pierre-muth/flipdot-ring/Screenshot 2026-03-23 202753.jpg

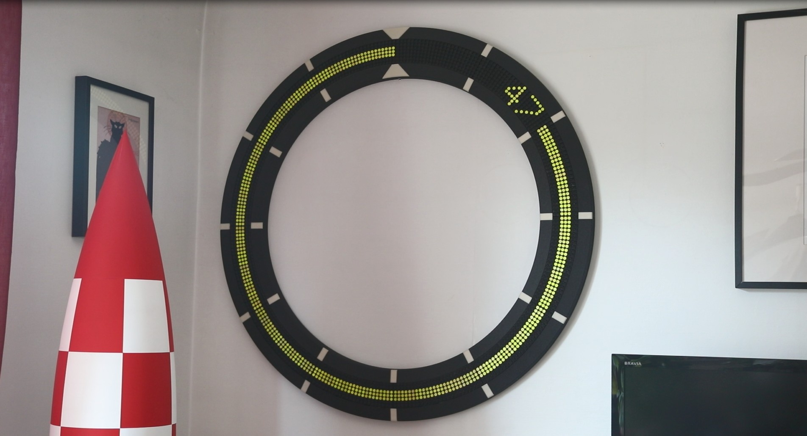
Screenshot 2026-03-23 202753.jpg
