pierre-muth/flipdot-ring/README.md

# flipdot-ring
Files of the flipdot-ring project
It's basically a big circular flipdot display acting as a clock.

Details on www.pierremuth.com

Youtube Polapi-zero video (https://www.youtube.com/watch?v=zJtOoa9Yafs)
