pierre-muth/flipdot-ring/KICAD/flipclock/flipclock.step

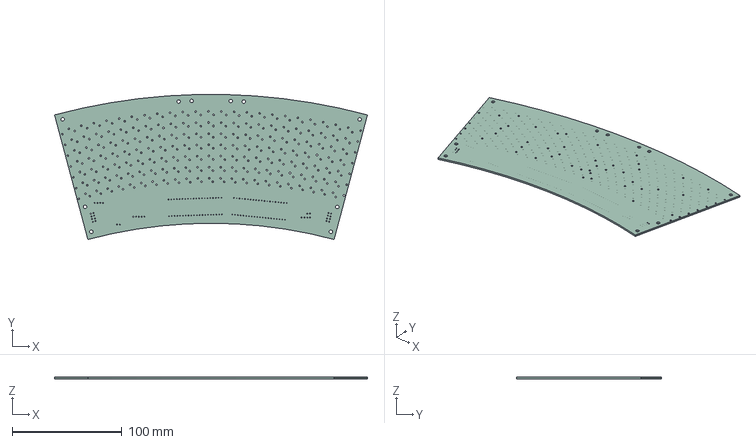
[picture p2: CAD file, 2025-12-02]
KICAD/flipclock/flipclock.step
285.2 x 132.1 x 1.51 mm
