pierre-muth/flipdot-ring/KICAD/flipclock/gerber_v1.0/flipclock-Edge_Cuts.dxf

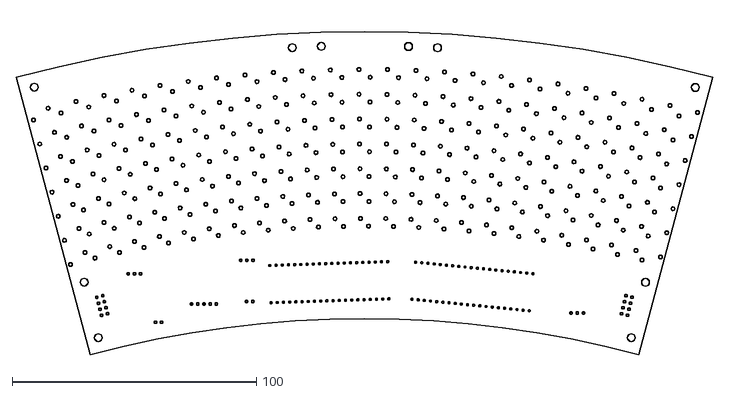
[picture p3: CAD file, 2025-12-02]
KICAD/flipclock/gerber_v1.0/flipclock-Edge_Cuts.dxf
285.2 x 138.5
