pierre-muth/flipdot-ring/KICAD/flipclock/flipclock.kicad_pcb

## KiCad design KICAD/flipclock/flipclock.kicad_pcb (2025-12-02)

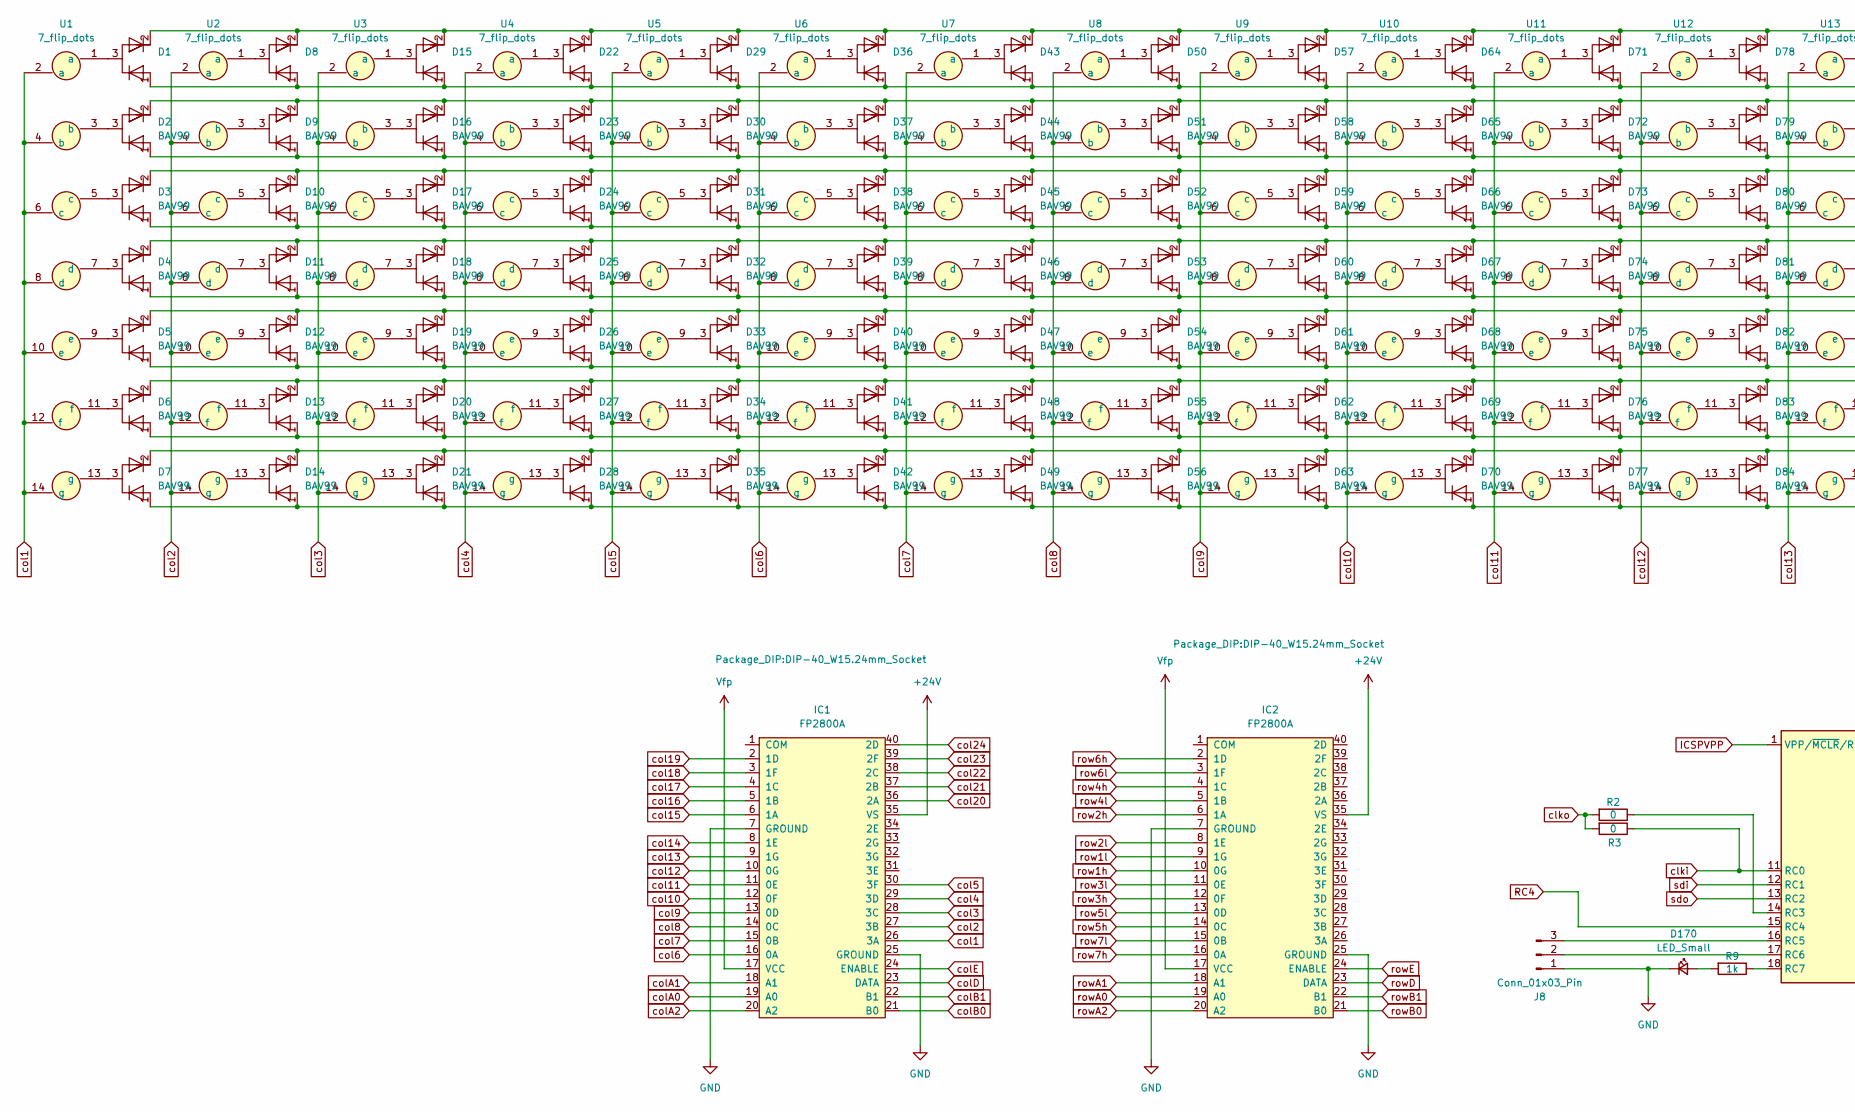
[picture p4: schematic flipclock.kicad_sch, part in row 1, column 1]

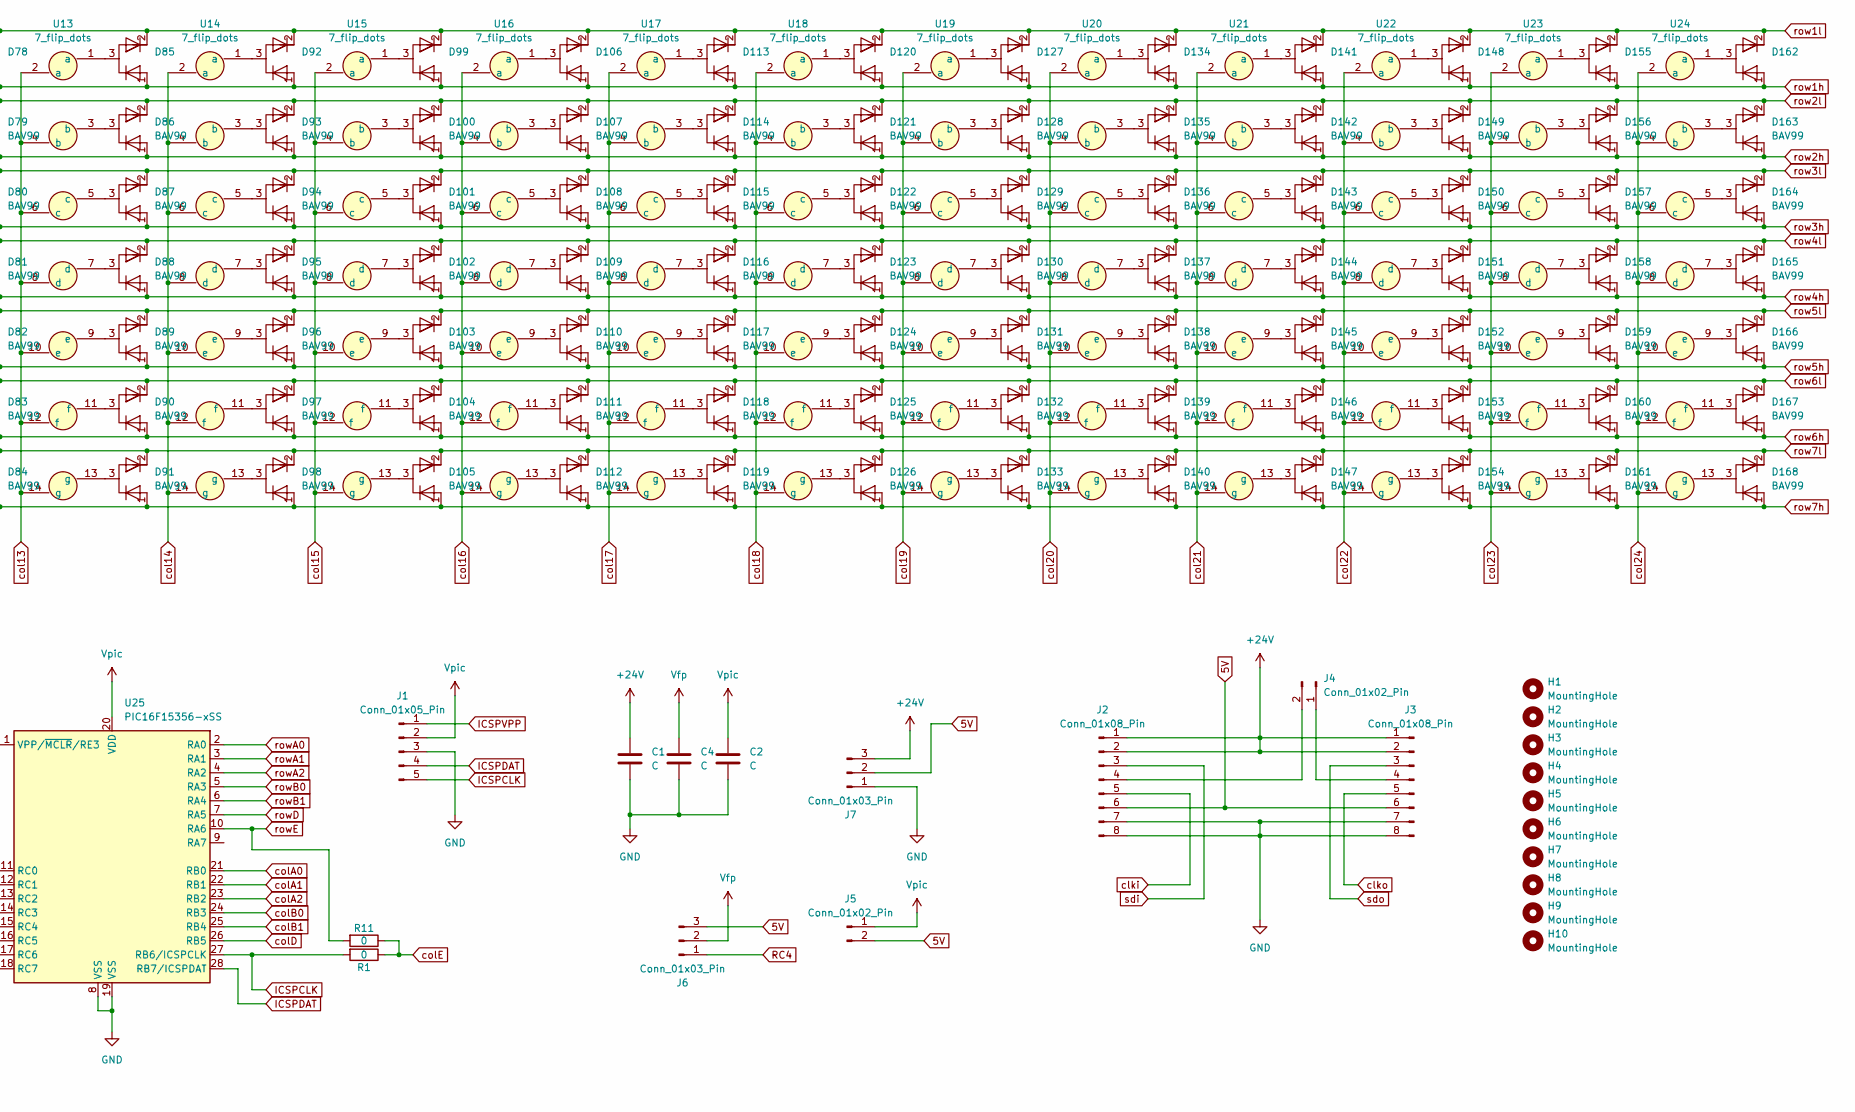
[picture p5: schematic flipclock.kicad_sch, part in row 1, column 2]

Parts:
C1, C2, C4: C; C_1210_3225Metric_Pad1.33x2.70mm_HandSolder
D1, D2, D3, D4, D5, D6, D7, D8, D9, D10, D11, D12, D13, D14, D15, D16, D17, D18, D19, D20, D21, D22, D23, D24, D25, D26, D27, D28, D29, D30, D31, D32, D33, D34, D35, D36, D37, D38, D39, D40, D41, D42, D43, D44, D45, D46, D47, D48, D49, D50, D51, D52, D53, D54, D55, D56, D57, D58, D59, D60, D61, D62, D63, D64, D65, D66, D67, D68, D69, D70, D71, D72, D73, D74, D75, D76, D77, D78, D79, D80, D81, D82, D83, D84, D85, D86, D87, D88, D89, D90, D91, D92, D93, D94, D95, D96, D97, D98, D99, D100, D101, D102, D103, D104, D105, D106, D107, D108, D109, D110, D111, D112, D113, D114, D115, D116, D117, D118, D119, D120, D121, D122, D123, D124, D125, D126, D127, D128, D129, D130, D131, D132, D133, D134, D135, D136, D137, D138, D139, D140, D141, D142, D143, D144, D145, D146, D147, D148, D149, D150, D151, D152, D153, D154, D155, D156, D157, D158, D159, D160, D161, D162, D163, D164, D165, D166, D167, D168: BAV99; SOT-23
D170: LED_Small; LED_0805_2012Metric
H1, H2, H3, H4, H5, H6, H7, H8, H9, H10: MountingHole; MountingHole_3.2mm_M3
IC1, IC2: FP2800A; DIP-40_W15.24mm_Socket
J1: Conn_01x05_Pin; PinHeader_1x05_P2.54mm_Vertical
J2, J3: Conn_01x08_Pin; PinHeader_2x04_P2.54mm_Vertical
J4, J5: Conn_01x02_Pin; PinHeader_1x02_P2.54mm_Vertical
J6, J7, J8: Conn_01x03_Pin; PinHeader_1x03_P2.54mm_Vertical
R1, R2, R3, R11: 0; R_0805_2012Metric
R9: 1k; R_0805_2012Metric
U1, U2, U3, U4, U5, U6, U7, U8, U9, U10, U11, U12, U13, U14, U15, U16, U17, U18, U19, U20, U21, U22, U23, U24: 7_flip_dots; 7x1flipdot
U25: PIC16F15356-xSS; SSOP-28_5.3x10.2mm_P0.65mm

Connections:
5V: J2.6, J3.6, J5.2, J6.3, J7.2
+24V: C1.2, IC1.35 (VS), IC2.35 (VS), J2.1, J2.2, J3.1, J3.2, J7.3
GND: C1.1, C2.1, C4.1, D170.1 (K), IC1.7 (GROUND), IC1.25 (GROUND), IC2.7 (GROUND), IC2.25 (GROUND), J1.3, J2.7, J2.8, J3.7, J3.8, J7.1, J8.1, U25.8 (VSS), U25.19 (VSS)
ICSPCLK: J1.5, R1.2, U25.27 (RB6/ICSPCLK)
ICSPDAT: J1.4, U25.28 (RB7/ICSPDAT)
ICSPVPP: J1.1, U25.1 (VPP/~MCLR/RE3)
unnamed: D1.3 (K), U1.1 (a)
unnamed: D2.3 (K), U1.3 (b)
unnamed: D3.3 (K), U1.5 (c)
unnamed: D4.3 (K), U1.7 (d)
unnamed: D5.3 (K), U1.9 (e)
unnamed: D6.3 (K), U1.11 (f)
unnamed: D7.3 (K), U1.13 (g)
unnamed: D8.3 (K), U2.1 (a)
unnamed: D9.3 (K), U2.3 (b)
unnamed: D10.3 (K), U2.5 (c)
unnamed: D11.3 (K), U2.7 (d)
unnamed: D12.3 (K), U2.9 (e)
unnamed: D13.3 (K), U2.11 (f)
unnamed: D14.3 (K), U2.13 (g)
unnamed: D15.3 (K), U3.1 (a)
unnamed: D16.3 (K), U3.3 (b)
unnamed: D17.3 (K), U3.5 (c)
unnamed: D18.3 (K), U3.7 (d)
unnamed: D19.3 (K), U3.9 (e)
unnamed: D20.3 (K), U3.11 (f)
unnamed: D21.3 (K), U3.13 (g)
unnamed: D22.3 (K), U4.1 (a)
unnamed: D23.3 (K), U4.3 (b)
unnamed: D24.3 (K), U4.5 (c)
unnamed: D25.3 (K), U4.7 (d)
unnamed: D26.3 (K), U4.9 (e)
unnamed: D27.3 (K), U4.11 (f)
unnamed: D28.3 (K), U4.13 (g)
unnamed: D29.3 (K), U5.1 (a)
unnamed: D30.3 (K), U5.3 (b)
unnamed: D31.3 (K), U5.5 (c)
unnamed: D32.3 (K), U5.7 (d)
unnamed: D33.3 (K), U5.9 (e)
unnamed: D34.3 (K), U5.11 (f)
unnamed: D35.3 (K), U5.13 (g)
unnamed: D36.3 (K), U6.1 (a)
unnamed: D37.3 (K), U6.3 (b)
unnamed: D38.3 (K), U6.5 (c)
unnamed: D39.3 (K), U6.7 (d)
unnamed: D40.3 (K), U6.9 (e)
unnamed: D41.3 (K), U6.11 (f)
unnamed: D42.3 (K), U6.13 (g)
unnamed: D43.3 (K), U7.1 (a)
unnamed: D44.3 (K), U7.3 (b)
unnamed: D45.3 (K), U7.5 (c)
unnamed: D46.3 (K), U7.7 (d)
unnamed: D47.3 (K), U7.9 (e)
unnamed: D48.3 (K), U7.11 (f)
unnamed: D49.3 (K), U7.13 (g)
unnamed: D50.3 (K), U8.1 (a)
unnamed: D51.3 (K), U8.3 (b)
unnamed: D52.3 (K), U8.5 (c)
unnamed: D53.3 (K), U8.7 (d)
unnamed: D54.3 (K), U8.9 (e)
unnamed: D55.3 (K), U8.11 (f)
unnamed: D56.3 (K), U8.13 (g)
unnamed: D57.3 (K), U9.1 (a)
unnamed: D58.3 (K), U9.3 (b)
unnamed: D59.3 (K), U9.5 (c)
unnamed: D60.3 (K), U9.7 (d)
unnamed: D61.3 (K), U9.9 (e)
unnamed: D62.3 (K), U9.11 (f)
unnamed: D63.3 (K), U9.13 (g)
unnamed: D64.3 (K), U10.1 (a)
unnamed: D65.3 (K), U10.3 (b)
unnamed: D66.3 (K), U10.5 (c)
unnamed: D67.3 (K), U10.7 (d)
unnamed: D68.3 (K), U10.9 (e)
unnamed: D69.3 (K), U10.11 (f)
unnamed: D70.3 (K), U10.13 (g)
unnamed: D71.3 (K), U11.1 (a)
unnamed: D72.3 (K), U11.3 (b)
unnamed: D73.3 (K), U11.5 (c)
unnamed: D74.3 (K), U11.7 (d)
unnamed: D75.3 (K), U11.9 (e)
unnamed: D76.3 (K), U11.11 (f)
unnamed: D77.3 (K), U11.13 (g)
unnamed: D78.3 (K), U12.1 (a)
unnamed: D79.3 (K), U12.3 (b)
unnamed: D80.3 (K), U12.5 (c)
unnamed: D81.3 (K), U12.7 (d)
unnamed: D82.3 (K), U12.9 (e)
unnamed: D83.3 (K), U12.11 (f)
unnamed: D84.3 (K), U12.13 (g)
unnamed: D85.3 (K), U13.1 (a)
unnamed: D86.3 (K), U13.3 (b)
unnamed: D87.3 (K), U13.5 (c)
unnamed: D88.3 (K), U13.7 (d)
unnamed: D89.3 (K), U13.9 (e)
unnamed: D90.3 (K), U13.11 (f)
unnamed: D91.3 (K), U13.13 (g)
unnamed: D92.3 (K), U14.1 (a)
unnamed: D93.3 (K), U14.3 (b)
unnamed: D94.3 (K), U14.5 (c)
unnamed: D95.3 (K), U14.7 (d)
unnamed: D96.3 (K), U14.9 (e)
unnamed: D97.3 (K), U14.11 (f)
unnamed: D98.3 (K), U14.13 (g)
unnamed: D99.3 (K), U15.1 (a)
unnamed: D100.3 (K), U15.3 (b)
unnamed: D101.3 (K), U15.5 (c)
unnamed: D102.3 (K), U15.7 (d)
unnamed: D103.3 (K), U15.9 (e)
unnamed: D104.3 (K), U15.11 (f)
unnamed: D105.3 (K), U15.13 (g)
unnamed: D106.3 (K), U16.1 (a)
unnamed: D107.3 (K), U16.3 (b)
unnamed: D108.3 (K), U16.5 (c)
unnamed: D109.3 (K), U16.7 (d)
unnamed: D110.3 (K), U16.9 (e)
unnamed: D111.3 (K), U16.11 (f)
unnamed: D112.3 (K), U16.13 (g)
unnamed: D113.3 (K), U17.1 (a)
unnamed: D114.3 (K), U17.3 (b)
unnamed: D115.3 (K), U17.5 (c)
unnamed: D116.3 (K), U17.7 (d)
unnamed: D117.3 (K), U17.9 (e)
unnamed: D118.3 (K), U17.11 (f)
unnamed: D119.3 (K), U17.13 (g)
unnamed: D120.3 (K), U18.1 (a)
unnamed: D121.3 (K), U18.3 (b)
unnamed: D122.3 (K), U18.5 (c)
unnamed: D123.3 (K), U18.7 (d)
unnamed: D124.3 (K), U18.9 (e)
unnamed: D125.3 (K), U18.11 (f)
unnamed: D126.3 (K), U18.13 (g)
unnamed: D127.3 (K), U19.1 (a)
unnamed: D128.3 (K), U19.3 (b)
unnamed: D129.3 (K), U19.5 (c)
unnamed: D130.3 (K), U19.7 (d)
unnamed: D131.3 (K), U19.9 (e)
unnamed: D132.3 (K), U19.11 (f)
unnamed: D133.3 (K), U19.13 (g)
unnamed: D134.3 (K), U20.1 (a)
unnamed: D135.3 (K), U20.3 (b)
unnamed: D136.3 (K), U20.5 (c)
unnamed: D137.3 (K), U20.7 (d)
unnamed: D138.3 (K), U20.9 (e)
unnamed: D139.3 (K), U20.11 (f)
unnamed: D140.3 (K), U20.13 (g)
unnamed: D141.3 (K), U21.1 (a)
unnamed: D142.3 (K), U21.3 (b)
unnamed: D143.3 (K), U21.5 (c)
unnamed: D144.3 (K), U21.7 (d)
unnamed: D145.3 (K), U21.9 (e)
unnamed: D146.3 (K), U21.11 (f)
unnamed: D147.3 (K), U21.13 (g)
unnamed: D148.3 (K), U22.1 (a)
unnamed: D149.3 (K), U22.3 (b)
unnamed: D150.3 (K), U22.5 (c)
unnamed: D151.3 (K), U22.7 (d)
unnamed: D152.3 (K), U22.9 (e)
unnamed: D153.3 (K), U22.11 (f)
unnamed: D154.3 (K), U22.13 (g)
unnamed: D155.3 (K), U23.1 (a)
unnamed: D156.3 (K), U23.3 (b)
unnamed: D157.3 (K), U23.5 (c)
unnamed: D158.3 (K), U23.7 (d)
unnamed: D159.3 (K), U23.9 (e)
unnamed: D160.3 (K), U23.11 (f)
unnamed: D161.3 (K), U23.13 (g)
unnamed: D162.3 (K), U24.1 (a)
unnamed: D163.3 (K), U24.3 (b)
unnamed: D164.3 (K), U24.5 (c)
unnamed: D165.3 (K), U24.7 (d)
unnamed: D166.3 (K), U24.9 (e)
unnamed: D167.3 (K), U24.11 (f)
unnamed: D168.3 (K), U24.13 (g)
unnamed: D170.2 (A), R9.2
unnamed: J2.4, J4.2
unnamed: J3.4, J4.1
unnamed: J8.2, U25.17 (RC6)
unnamed: J8.3, U25.16 (RC5)
unnamed: R2.1, U25.14 (RC3)
unnamed: R9.1, U25.18 (RC7)
RC4: J6.1, U25.15 (RC4)
Vfp: C4.2, IC1.17 (VCC), IC2.17 (VCC), J6.2
Vpic: C2.2, J1.2, J5.1, U25.20 (VDD)
clki: J2.5, R3.1, U25.11 (RC0)
clko: J3.5, R2.2, R3.2
col1: IC1.26 (3A), U1.2 (a), U1.4 (b), U1.6 (c), U1.8 (d), U1.10 (e), U1.12 (f), U1.14 (g)
col2: IC1.27 (3B), U2.2 (a), U2.4 (b), U2.6 (c), U2.8 (d), U2.10 (e), U2.12 (f), U2.14 (g)
col3: IC1.28 (3C), U3.2 (a), U3.4 (b), U3.6 (c), U3.8 (d), U3.10 (e), U3.12 (f), U3.14 (g)
col4: IC1.29 (3D), U4.2 (a), U4.4 (b), U4.6 (c), U4.8 (d), U4.10 (e), U4.12 (f), U4.14 (g)
col5: IC1.30 (3F), U5.2 (a), U5.4 (b), U5.6 (c), U5.8 (d), U5.10 (e), U5.12 (f), U5.14 (g)
col6: IC1.16 (0A), U6.2 (a), U6.4 (b), U6.6 (c), U6.8 (d), U6.10 (e), U6.12 (f), U6.14 (g)
col7: IC1.15 (0B), U7.2 (a), U7.4 (b), U7.6 (c), U7.8 (d), U7.10 (e), U7.12 (f), U7.14 (g)
col8: IC1.14 (0C), U8.2 (a), U8.4 (b), U8.6 (c), U8.8 (d), U8.10 (e), U8.12 (f), U8.14 (g)
col9: IC1.13 (0D), U9.2 (a), U9.4 (b), U9.6 (c), U9.8 (d), U9.10 (e), U9.12 (f), U9.14 (g)
col10: IC1.12 (0F), U10.2 (a), U10.4 (b), U10.6 (c), U10.8 (d), U10.10 (e), U10.12 (f), U10.14 (g)
col11: IC1.11 (0E), U11.2 (a), U11.4 (b), U11.6 (c), U11.8 (d), U11.10 (e), U11.12 (f), U11.14 (g)
col12: IC1.10 (0G), U12.2 (a), U12.4 (b), U12.6 (c), U12.8 (d), U12.10 (e), U12.12 (f), U12.14 (g)
col13: IC1.9 (1G), U13.2 (a), U13.4 (b), U13.6 (c), U13.8 (d), U13.10 (e), U13.12 (f), U13.14 (g)
col14: IC1.8 (1E), U14.2 (a), U14.4 (b), U14.6 (c), U14.8 (d), U14.10 (e), U14.12 (f), U14.14 (g)
col15: IC1.6 (1A), U15.2 (a), U15.4 (b), U15.6 (c), U15.8 (d), U15.10 (e), U15.12 (f), U15.14 (g)
col16: IC1.5 (1B), U16.2 (a), U16.4 (b), U16.6 (c), U16.8 (d), U16.10 (e), U16.12 (f), U16.14 (g)
col17: IC1.4 (1C), U17.2 (a), U17.4 (b), U17.6 (c), U17.8 (d), U17.10 (e), U17.12 (f), U17.14 (g)
col18: IC1.3 (1F), U18.2 (a), U18.4 (b), U18.6 (c), U18.8 (d), U18.10 (e), U18.12 (f), U18.14 (g)
col19: IC1.2 (1D), U19.2 (a), U19.4 (b), U19.6 (c), U19.8 (d), U19.10 (e), U19.12 (f), U19.14 (g)
col20: IC1.36 (2A), U20.2 (a), U20.4 (b), U20.6 (c), U20.8 (d), U20.10 (e), U20.12 (f), U20.14 (g)
col21: IC1.37 (2B), U21.2 (a), U21.4 (b), U21.6 (c), U21.8 (d), U21.10 (e), U21.12 (f), U21.14 (g)
col22: IC1.38 (2C), U22.2 (a), U22.4 (b), U22.6 (c), U22.8 (d), U22.10 (e), U22.12 (f), U22.14 (g)
col23: IC1.39 (2F), U23.2 (a), U23.4 (b), U23.6 (c), U23.8 (d), U23.10 (e), U23.12 (f), U23.14 (g)
col24: IC1.40 (2D), U24.2 (a), U24.4 (b), U24.6 (c), U24.8 (d), U24.10 (e), U24.12 (f), U24.14 (g)
colA0: IC1.19 (A0), U25.21 (RB0)
colA1: IC1.18 (A1), U25.22 (RB1)
colA2: IC1.20 (A2), U25.23 (RB2)
colB0: IC1.21 (B0), U25.24 (RB3)
colB1: IC1.22 (B1), U25.25 (RB4)
colD: IC1.23 (DATA), U25.26 (RB5)
colE: IC1.24 (ENABLE), R1.1, R11.1
row1h: D1.1 (K), D8.1 (K), D15.1 (K), D22.1 (K), D29.1 (K), D36.1 (K), D43.1 (K), D50.1 (K), D57.1 (K), D64.1 (K), D71.1 (K), D78.1 (K), D85.1 (K), D92.1 (K), D99.1 (K), D106.1 (K), D113.1 (K), D120.1 (K), D127.1 (K), D134.1 (K), D141.1 (K), D148.1 (K), D155.1 (K), D162.1 (K), IC2.10 (0G)
row1l: D1.2 (A), D8.2 (A), D15.2 (A), D22.2 (A), D29.2 (A), D36.2 (A), D43.2 (A), D50.2 (A), D57.2 (A), D64.2 (A), D71.2 (A), D78.2 (A), D85.2 (A), D92.2 (A), D99.2 (A), D106.2 (A), D113.2 (A), D120.2 (A), D127.2 (A), D134.2 (A), D141.2 (A), D148.2 (A), D155.2 (A), D162.2 (A), IC2.9 (1G)
row2h: D2.1 (K), D9.1 (K), D16.1 (K), D23.1 (K), D30.1 (K), D37.1 (K), D44.1 (K), D51.1 (K), D58.1 (K), D65.1 (K), D72.1 (K), D79.1 (K), D86.1 (K), D93.1 (K), D100.1 (K), D107.1 (K), D114.1 (K), D121.1 (K), D128.1 (K), D135.1 (K), D142.1 (K), D149.1 (K), D156.1 (K), D163.1 (K), IC2.6 (1A)
row2l: D2.2 (A), D9.2 (A), D16.2 (A), D23.2 (A), D30.2 (A), D37.2 (A), D44.2 (A), D51.2 (A), D58.2 (A), D65.2 (A), D72.2 (A), D79.2 (A), D86.2 (A), D93.2 (A), D100.2 (A), D107.2 (A), D114.2 (A), D121.2 (A), D128.2 (A), D135.2 (A), D142.2 (A), D149.2 (A), D156.2 (A), D163.2 (A), IC2.8 (1E)
row3h: D3.1 (K), D10.1 (K), D17.1 (K), D24.1 (K), D31.1 (K), D38.1 (K), D45.1 (K), D52.1 (K), D59.1 (K), D66.1 (K), D73.1 (K), D80.1 (K), D87.1 (K), D94.1 (K), D101.1 (K), D108.1 (K), D115.1 (K), D122.1 (K), D129.1 (K), D136.1 (K), D143.1 (K), D150.1 (K), D157.1 (K), D164.1 (K), IC2.12 (0F)
row3l: D3.2 (A), D10.2 (A), D17.2 (A), D24.2 (A), D31.2 (A), D38.2 (A), D45.2 (A), D52.2 (A), D59.2 (A), D66.2 (A), D73.2 (A), D80.2 (A), D87.2 (A), D94.2 (A), D101.2 (A), D108.2 (A), D115.2 (A), D122.2 (A), D129.2 (A), D136.2 (A), D143.2 (A), D150.2 (A), D157.2 (A), D164.2 (A), IC2.11 (0E)
row4h: D4.1 (K), D11.1 (K), D18.1 (K), D25.1 (K), D32.1 (K), D39.1 (K), D46.1 (K), D53.1 (K), D60.1 (K), D67.1 (K), D74.1 (K), D81.1 (K), D88.1 (K), D95.1 (K), D102.1 (K), D109.1 (K), D116.1 (K), D123.1 (K), D130.1 (K), D137.1 (K), D144.1 (K), D151.1 (K), D158.1 (K), D165.1 (K), IC2.4 (1C)
row4l: D4.2 (A), D11.2 (A), D18.2 (A), D25.2 (A), D32.2 (A), D39.2 (A), D46.2 (A), D53.2 (A), D60.2 (A), D67.2 (A), D74.2 (A), D81.2 (A), D88.2 (A), D95.2 (A), D102.2 (A), D109.2 (A), D116.2 (A), D123.2 (A), D130.2 (A), D137.2 (A), D144.2 (A), D151.2 (A), D158.2 (A), D165.2 (A), IC2.5 (1B)
row5h: D5.1 (K), D12.1 (K), D19.1 (K), D26.1 (K), D33.1 (K), D40.1 (K), D47.1 (K), D54.1 (K), D61.1 (K), D68.1 (K), D75.1 (K), D82.1 (K), D89.1 (K), D96.1 (K), D103.1 (K), D110.1 (K), D117.1 (K), D124.1 (K), D131.1 (K), D138.1 (K), D145.1 (K), D152.1 (K), D159.1 (K), D166.1 (K), IC2.14 (0C)
row5l: D5.2 (A), D12.2 (A), D19.2 (A), D26.2 (A), D33.2 (A), D40.2 (A), D47.2 (A), D54.2 (A), D61.2 (A), D68.2 (A), D75.2 (A), D82.2 (A), D89.2 (A), D96.2 (A), D103.2 (A), D110.2 (A), D117.2 (A), D124.2 (A), D131.2 (A), D138.2 (A), D145.2 (A), D152.2 (A), D159.2 (A), D166.2 (A), IC2.13 (0D)
row6h: D6.1 (K), D13.1 (K), D20.1 (K), D27.1 (K), D34.1 (K), D41.1 (K), D48.1 (K), D55.1 (K), D62.1 (K), D69.1 (K), D76.1 (K), D83.1 (K), D90.1 (K), D97.1 (K), D104.1 (K), D111.1 (K), D118.1 (K), D125.1 (K), D132.1 (K), D139.1 (K), D146.1 (K), D153.1 (K), D160.1 (K), D167.1 (K), IC2.2 (1D)
row6l: D6.2 (A), D13.2 (A), D20.2 (A), D27.2 (A), D34.2 (A), D41.2 (A), D48.2 (A), D55.2 (A), D62.2 (A), D69.2 (A), D76.2 (A), D83.2 (A), D90.2 (A), D97.2 (A), D104.2 (A), D111.2 (A), D118.2 (A), D125.2 (A), D132.2 (A), D139.2 (A), D146.2 (A), D153.2 (A), D160.2 (A), D167.2 (A), IC2.3 (1F)
row7h: D7.1 (K), D14.1 (K), D21.1 (K), D28.1 (K), D35.1 (K), D42.1 (K), D49.1 (K), D56.1 (K), D63.1 (K), D70.1 (K), D77.1 (K), D84.1 (K), D91.1 (K), D98.1 (K), D105.1 (K), D112.1 (K), D119.1 (K), D126.1 (K), D133.1 (K), D140.1 (K), D147.1 (K), D154.1 (K), D161.1 (K), D168.1 (K), IC2.16 (0A)
row7l: D7.2 (A), D14.2 (A), D21.2 (A), D28.2 (A), D35.2 (A), D42.2 (A), D49.2 (A), D56.2 (A), D63.2 (A), D70.2 (A), D77.2 (A), D84.2 (A), D91.2 (A), D98.2 (A), D105.2 (A), D112.2 (A), D119.2 (A), D126.2 (A), D133.2 (A), D140.2 (A), D147.2 (A), D154.2 (A), D161.2 (A), D168.2 (A), IC2.15 (0B)
rowA0: IC2.19 (A0), U25.2 (RA0)
rowA1: IC2.18 (A1), U25.3 (RA1)
rowA2: IC2.20 (A2), U25.4 (RA2)
rowB0: IC2.21 (B0), U25.5 (RA3)
rowB1: IC2.22 (B1), U25.6 (RA4)
rowD: IC2.23 (DATA), U25.7 (RA5)
rowE: IC2.24 (ENABLE), R11.2, U25.10 (RA6)
sdi: J2.3, U25.12 (RC1)
sdo: J3.3, U25.13 (RC2)

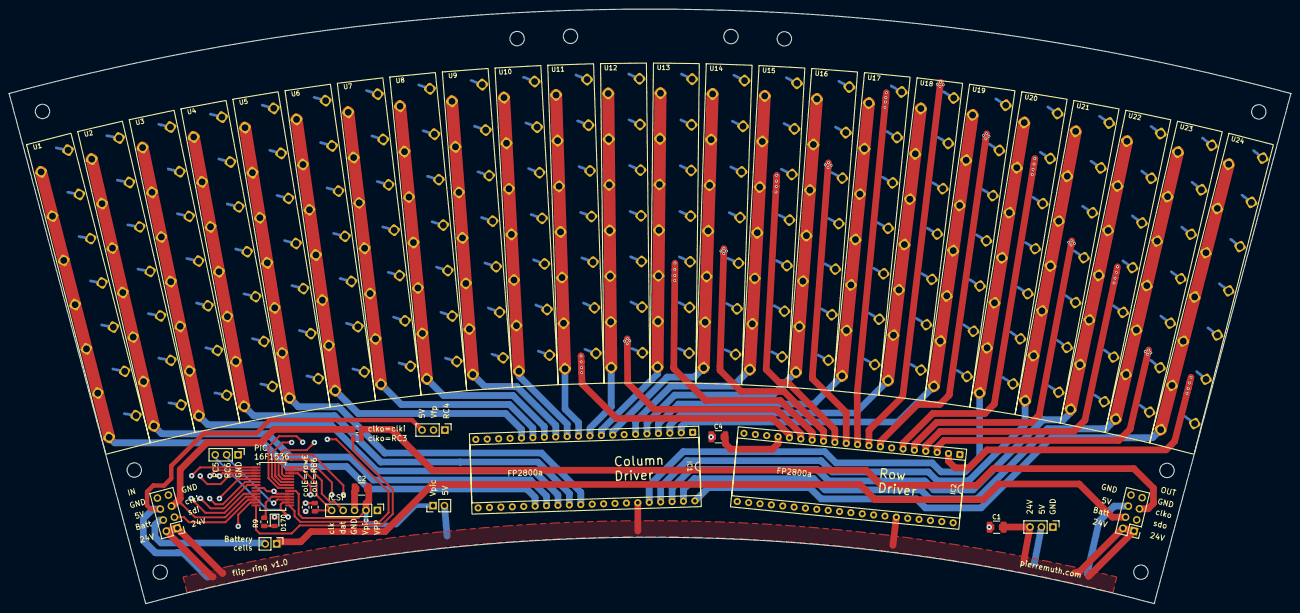
[picture p6: board flipclock.kicad_pcb from above]

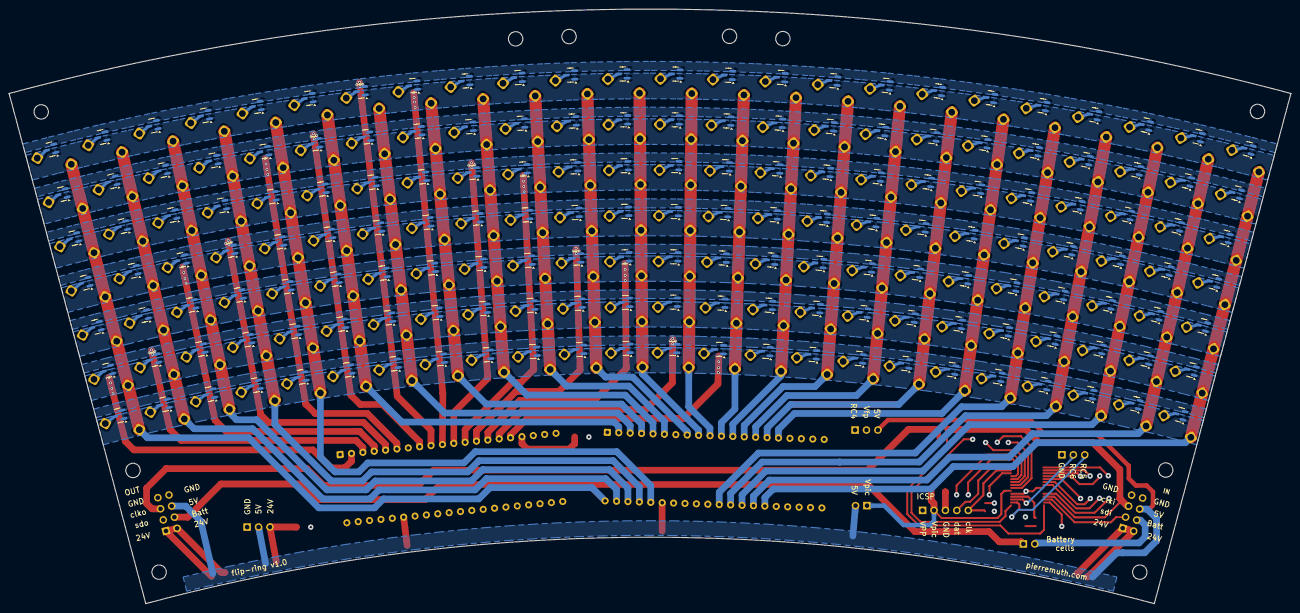
[picture p7: board flipclock.kicad_pcb from below]

Board: 4 copper layers, 285.2 x 132.3 mm, 222 parts (168 on the bottom side), 240 nets.
