pierre-muth/flipdot-ring/(commit log)

2026-03-13 Update todo.txt with completed tasks and notes
    Added completed tasks for voltage divider and PIC/ESP32 code updates.
2026-03-15 ADC for main battery and Wakeup button
